rolfluc/ElectronicCribbage/readme.md

Repo Housing everything related to the electronic cribbage board project.
SW/ Contains everything for SW, including for test boards.
EE/ Contains all electrical aspects
HW/ Contains all HW related aspects
