rolfluc/ElectronicCribbage/EE/Main/MainBoard/MainBoard.step

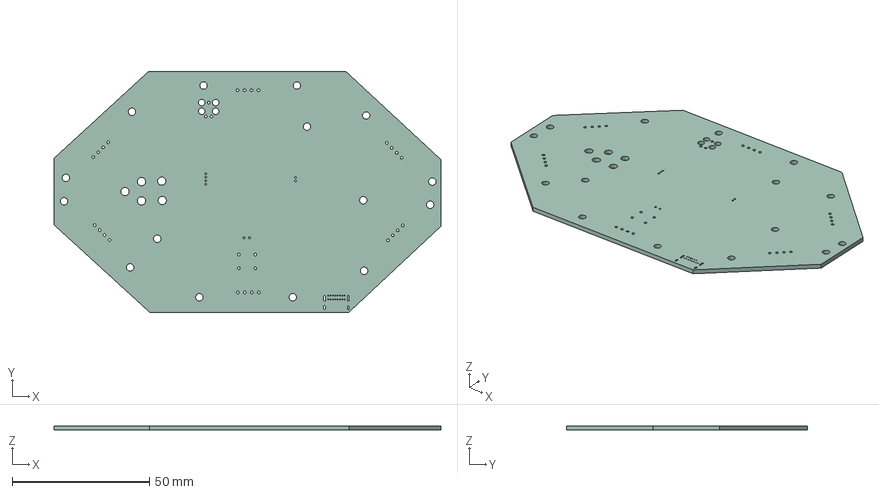
[picture p1: CAD file, 2025-07-29]
EE/Main/MainBoard/MainBoard.step
140.8 x 87.5 x 1.60 mm
