rolfluc/ElectronicCribbage/EE/Sensing/SensorBoard/SensorBoard.step

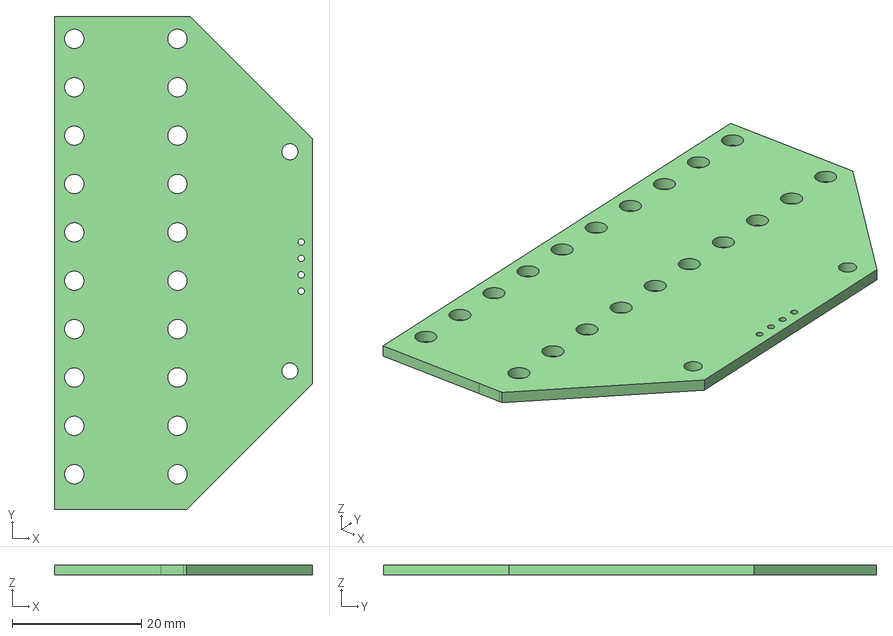
[picture p2: CAD file, 2024-10-20]
EE/Sensing/SensorBoard/SensorBoard.step
40.0 x 76.5 x 1.60 mm
