rolfluc/ElectronicCribbage/HW/CribbageCase.FCStd

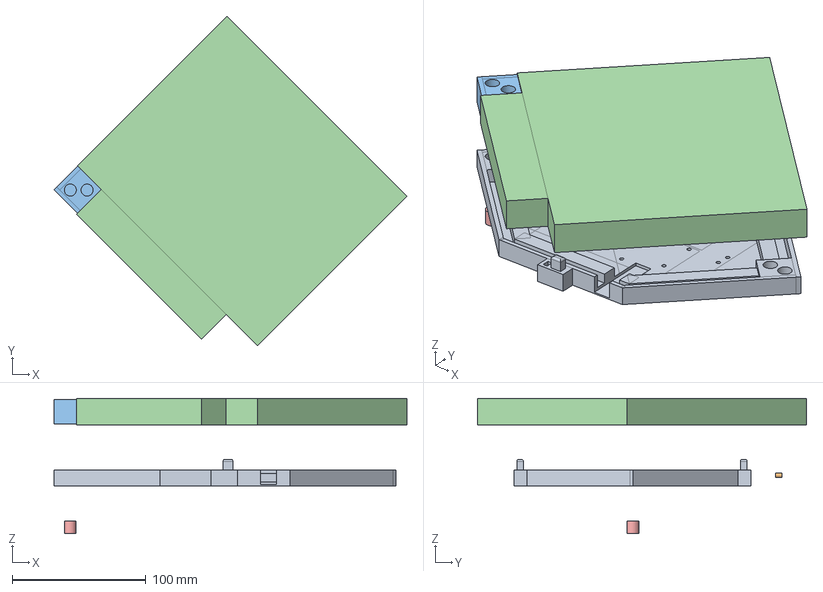
[picture p3: CAD file, 2025-08-26]
HW/CribbageCase.FCStd
263.7 x 246.1 x 101.0 mm
Magnet
