rolfluc/ElectronicCribbage/HW/CribbagePeg.FCStd

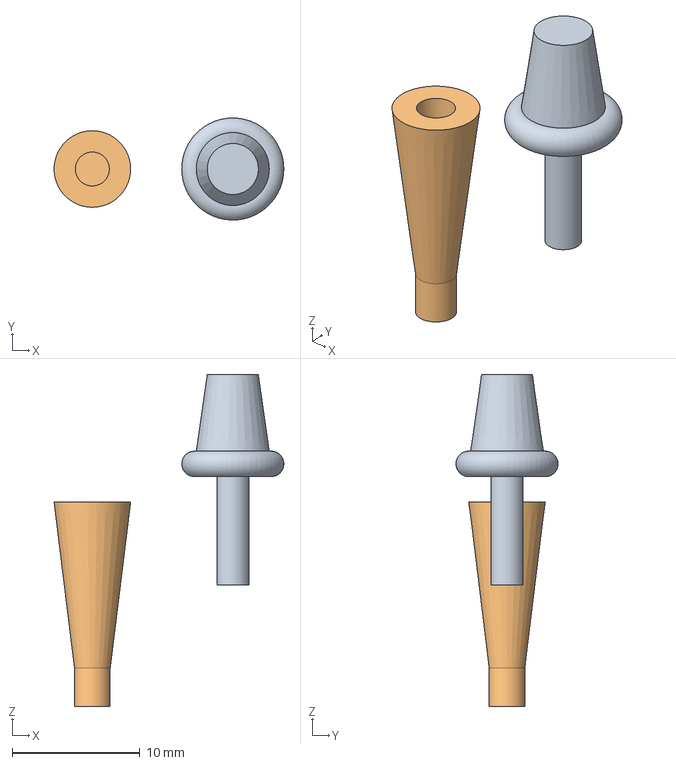
[picture p4: CAD file, 2025-08-24]
HW/CribbagePeg.FCStd
18.0 x 8.00 x 26.0 mm
