rolfluc/ElectronicCribbage/EE/Main/Power_DriveTest/PowerDriveTest/PowerDriveTest.kicad_pcb

## KiCad design EE/Main/Power_DriveTest/PowerDriveTest/PowerDriveTest.kicad_pcb (2025-08-29)

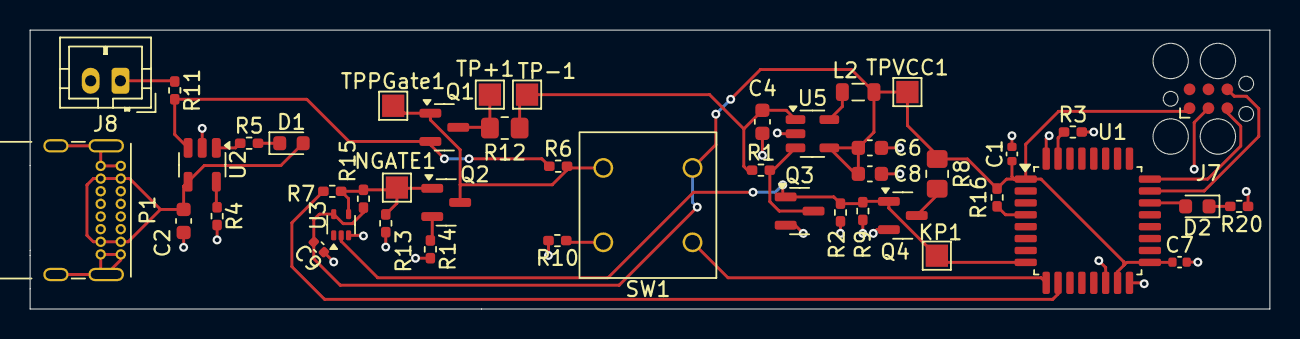
[picture p5: board PowerDriveTest.kicad_pcb from above]

Board: 2 copper layers, 83.3 x 18.8 mm, 45 parts (0 on the bottom side), 26 nets.

Parts:
C1, C7, C9: 0.1u; C_0402_1005Metric
C2, C4, C6, C8: 4.7u; C_0603_1608Metric
D1, D2: LED; LED_0603_1608Metric
J7: TAG_CONNECT; Tag-Connect_TC2030-IDC-FP_2x03_P1.27mm_Vertical
J8: Conn_01x02_Male; JST_PH_B2B-PH-K_1x02_P2.00mm_Vertical
KP1: TestPoint; TestPoint_Pad_1.5x1.5mm
L2: 4.7u; L_0805_2012Metric
NGATE1: TestPoint; TestPoint_Pad_1.5x1.5mm
P1: USB_C_Plug_USB2.0; USB_C_Receptacle_GCT_USB4085
Q1: Q_PMOS_GSD; SOT-23
Q2, Q3, Q4: Q_NMOS_GSD; SOT-23
R1, R2, R9, R13: 100k; R_0402_1005Metric_Pad0.72x0.64mm_HandSolder
R3, R4, R10, R14, R16: 10k; R_0402_1005Metric_Pad0.72x0.64mm_HandSolder
R5, R20: 4.7k; R_0402_1005Metric_Pad0.72x0.64mm_HandSolder
R6: 1M; R_0402_1005Metric_Pad0.72x0.64mm_HandSolder
R7, R11: 0; R_0402_1005Metric_Pad0.72x0.64mm_HandSolder
R8: 10; R_0805_2012Metric_Pad1.20x1.40mm_HandSolder
R12: 25m; R_0805_2012Metric_Pad1.20x1.40mm_HandSolder
R15: 10K; R_0402_1005Metric_Pad0.72x0.64mm_HandSolder
SW1: SW_DPST; 401-1133-ND
TP+1: TestPoint; TestPoint_Pad_1.5x1.5mm
TP-1: TestPoint; TestPoint_Pad_1.5x1.5mm
TPPGate1: TestPoint; TestPoint_Pad_1.5x1.5mm
TPVCC1: TestPoint; TestPoint_Pad_1.5x1.5mm
U1: STM32G431K6Tx; LQFP-32_7x7mm_P0.8mm
U2: MCP73832-2-OT; SOT-23-5
U3: 74LVC1GU04DRL; SOT-553
U5: LM3670MF-3.3; TSOT-23-5

Connections:
+3V3: C1.1, C6.1, C7.1, C8.1, C9.1, J7.1 (POWER_3V3), L2.2, R8.1, R15.1, R16.1, SW1.1, TPVCC1.1, U1.1 (VDD), U1.15 (VDDA), U1.17 (VDD), U3.5 (VCC), U5.4 (FB)
/BTN_SNS: SW1.2, U1.9 (PA4)
/EN: Q3.3 (D), R1.2, U5.3 (EN)
/HB: D2.2 (A), U1.22 (PA12)
/KillPower: KP1.1, Q3.1 (G), Q4.1 (G), R2.1, R9.1, U1.8 (PA3), U3.2
/N_GATE: R7.1, U1.10 (PA5)
/N_SOURCE: Q2.2 (S), R14.1
/P_DRAIN: Q1.3 (D), R12.2, TP+1.1
/SWDCLK: J7.5 (SWCLK), U1.24 (PA14)
/SWDIO: J7.6 (SWDIO), U1.23 (PA13)
/VBAT: Q1.2 (S), R6.1, R11.2, U2.3 (VBAT)
/VBAT_OUT: C4.1, R1.1, R12.1, TP-1.1, U5.1 (Vin)
GND: C1.2, C2.2, C4.2, C6.2, C7.2, C8.2, C9.2, J7.3 (GND), J8.2, P1.A1 (GND), P1.A12 (GND), P1.B1 (GND), P1.B12 (GND), P1.S1 (SHIELD), Q3.2 (S), Q4.2 (S), R2.2, R3.2, R4.2, R9.2, R10.2, R13.2, R14.2, R20.1, U1.14 (VSSA), U1.16 (VSS), U1.32 (VSS), U2.2 (VSS), U3.3 (GND), U5.2 (GND)
unnamed: D1.1 (K), R5.2
unnamed: D2.1 (K), R20.2
unnamed: J8.1, R11.1
unnamed: Q1.1 (G), Q2.3 (D), R6.2, SW1.3, TPPGate1.1
unnamed: NGATE1.1, Q2.1 (G), R7.2, R13.1, R15.2, U3.4
unnamed: Q4.3 (D), R8.2
unnamed: R10.1, SW1.4
unnamed: R3.1, U1.31 (PB8)
unnamed: R16.2, U1.4 (PG10)
unnamed: R4.1, U2.5 (PROG)
unnamed: R5.1, U2.1 (STAT)
unnamed: L2.1, U5.5 (SW)
VBUS: C2.1, D1.2 (A), P1.A4 (VBUS), P1.A9 (VBUS), P1.B4 (VBUS), P1.B9 (VBUS), U2.4 (VDD)
