rolfluc/ElectronicCribbage/EE/Sensing/SensorBoard/SensorBoard.kicad_pcb

## KiCad design EE/Sensing/SensorBoard/SensorBoard.kicad_pcb (2024-10-02)

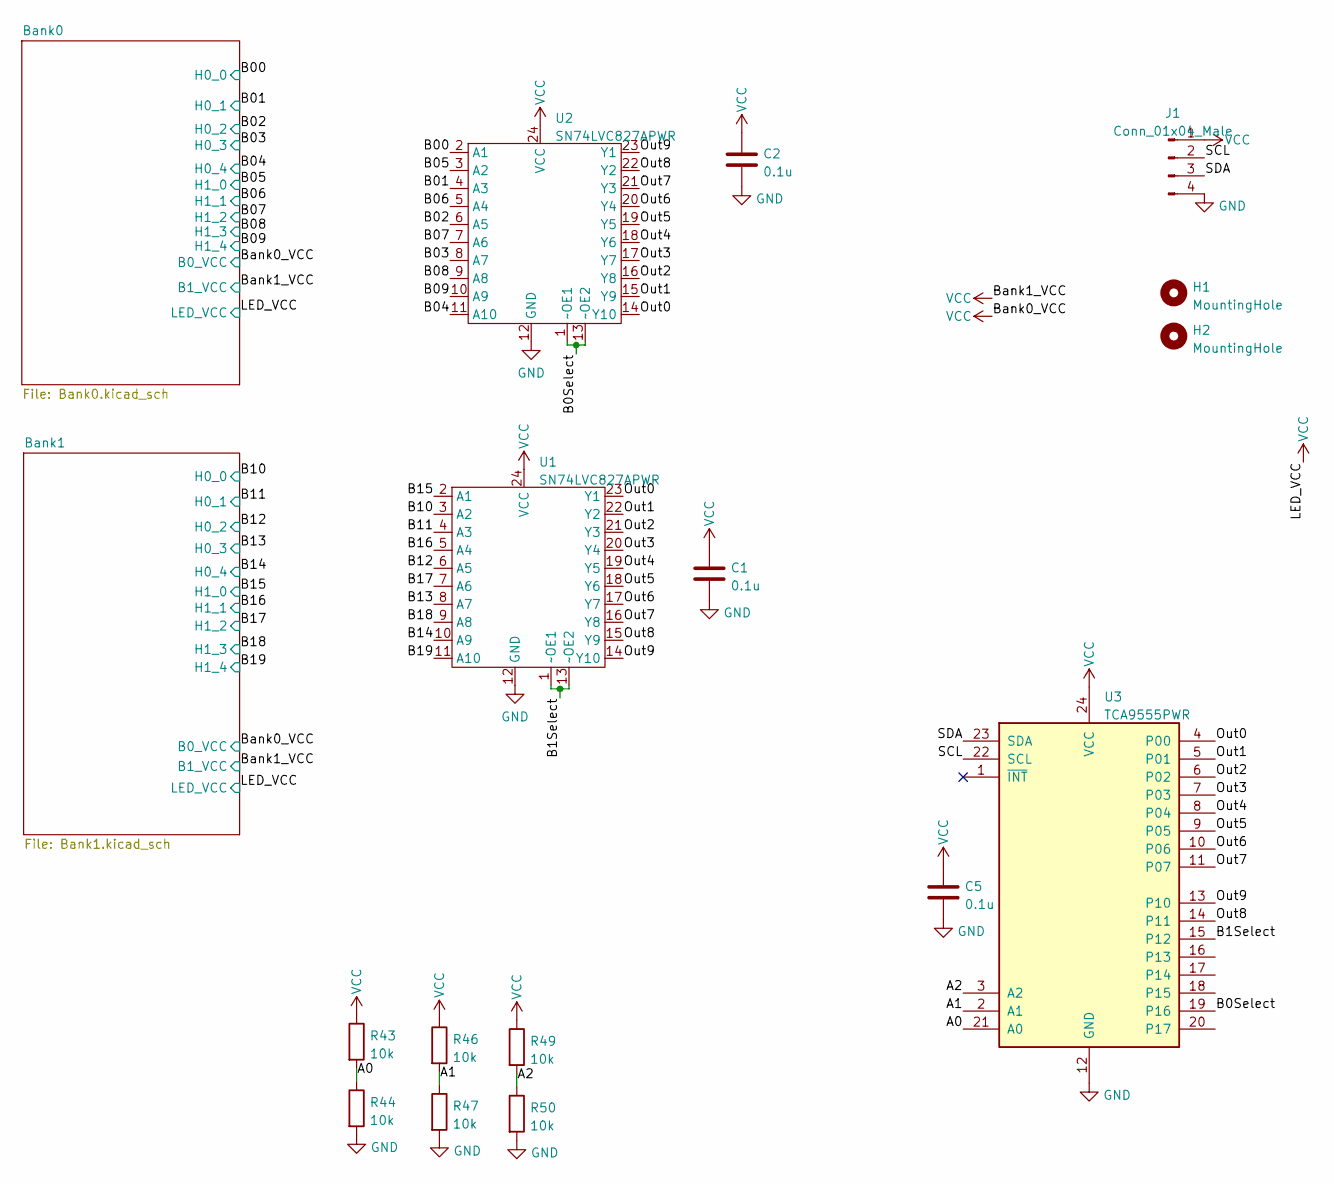
[picture p6: schematic SensorBoard.kicad_sch]

Parts:
C1, C2, C5: 0.1u; C_0402_1005Metric
H1, H2: MountingHole; MountingHole_2.5mm
J1: Conn_01x04_Male; PinSocket_1x04_P2.54mm_Vertical
R43, R44, R46, R47, R49, R50: 10k; R_0402_1005Metric
U1, U2: SN74LVC827APWR; TSSOP-24_4.4x7.8mm_P0.65mm
U3: TCA9555PWR; TSSOP-24_4.4x7.8mm_P0.65mm

Connections:
/A0: R43.2, R44.1, U3.21 (A0)
/A1: R46.2, R47.1, U3.2 (A1)
/A2: R49.2, R50.1, U3.3 (A2)
/B00: U2.2 (A1); also elsewhere on the board
/B0Select: U2.1 (~OE1), U2.13 (~OE2), U3.19 (P16)
/B01: U2.4 (A3); also elsewhere on the board
/B1Select: U1.1 (~OE1), U1.13 (~OE2), U3.15 (P12)
/B02: U2.6 (A5); also elsewhere on the board
/B03: U2.8 (A7); also elsewhere on the board
/B04: U2.11 (A10); also elsewhere on the board
/B05: U2.3 (A2); also elsewhere on the board
/B06: U2.5 (A4); also elsewhere on the board
/B07: U2.7 (A6); also elsewhere on the board
/B08: U2.9 (A8); also elsewhere on the board
/B09: U2.10 (A9); also elsewhere on the board
/B10: U1.3 (A2); also elsewhere on the board
/B11: U1.4 (A3); also elsewhere on the board
/B12: U1.6 (A5); also elsewhere on the board
/B13: U1.8 (A7); also elsewhere on the board
/B14: U1.10 (A9); also elsewhere on the board
/B15: U1.2 (A1); also elsewhere on the board
/B16: U1.5 (A4); also elsewhere on the board
/B17: U1.7 (A6); also elsewhere on the board
/B18: U1.9 (A8); also elsewhere on the board
/B19: U1.11 (A10); also elsewhere on the board
/Out0: U1.23 (Y1), U2.14 (Y10), U3.4 (P00)
/Out1: U1.22 (Y2), U2.15 (Y9), U3.5 (P01)
/Out2: U1.21 (Y3), U2.16 (Y8), U3.6 (P02)
/Out3: U1.20 (Y4), U2.17 (Y7), U3.7 (P03)
/Out4: U1.19 (Y5), U2.18 (Y6), U3.8 (P04)
/Out5: U1.18 (Y6), U2.19 (Y5), U3.9 (P05)
/Out6: U1.17 (Y7), U2.20 (Y4), U3.10 (P06)
/Out7: U1.16 (Y8), U2.21 (Y3), U3.11 (P07)
/Out8: U1.15 (Y9), U2.22 (Y2), U3.14 (P11)
/Out9: U1.14 (Y10), U2.23 (Y1), U3.13 (P10)
/SCL: J1.2, U3.22 (SCL)
/SDA: J1.3, U3.23 (SDA)
GND: C1.2, C2.2, C5.2, J1.4, R44.2, R47.2, R50.2, U1.12 (GND), U2.12 (GND), U3.12 (GND); also elsewhere on the board
VCC: C1.1, C2.1, C5.1, J1.1, R43.1, R46.1, R49.1, U1.24 (VCC), U2.24 (VCC), U3.24 (VCC); also elsewhere on the board

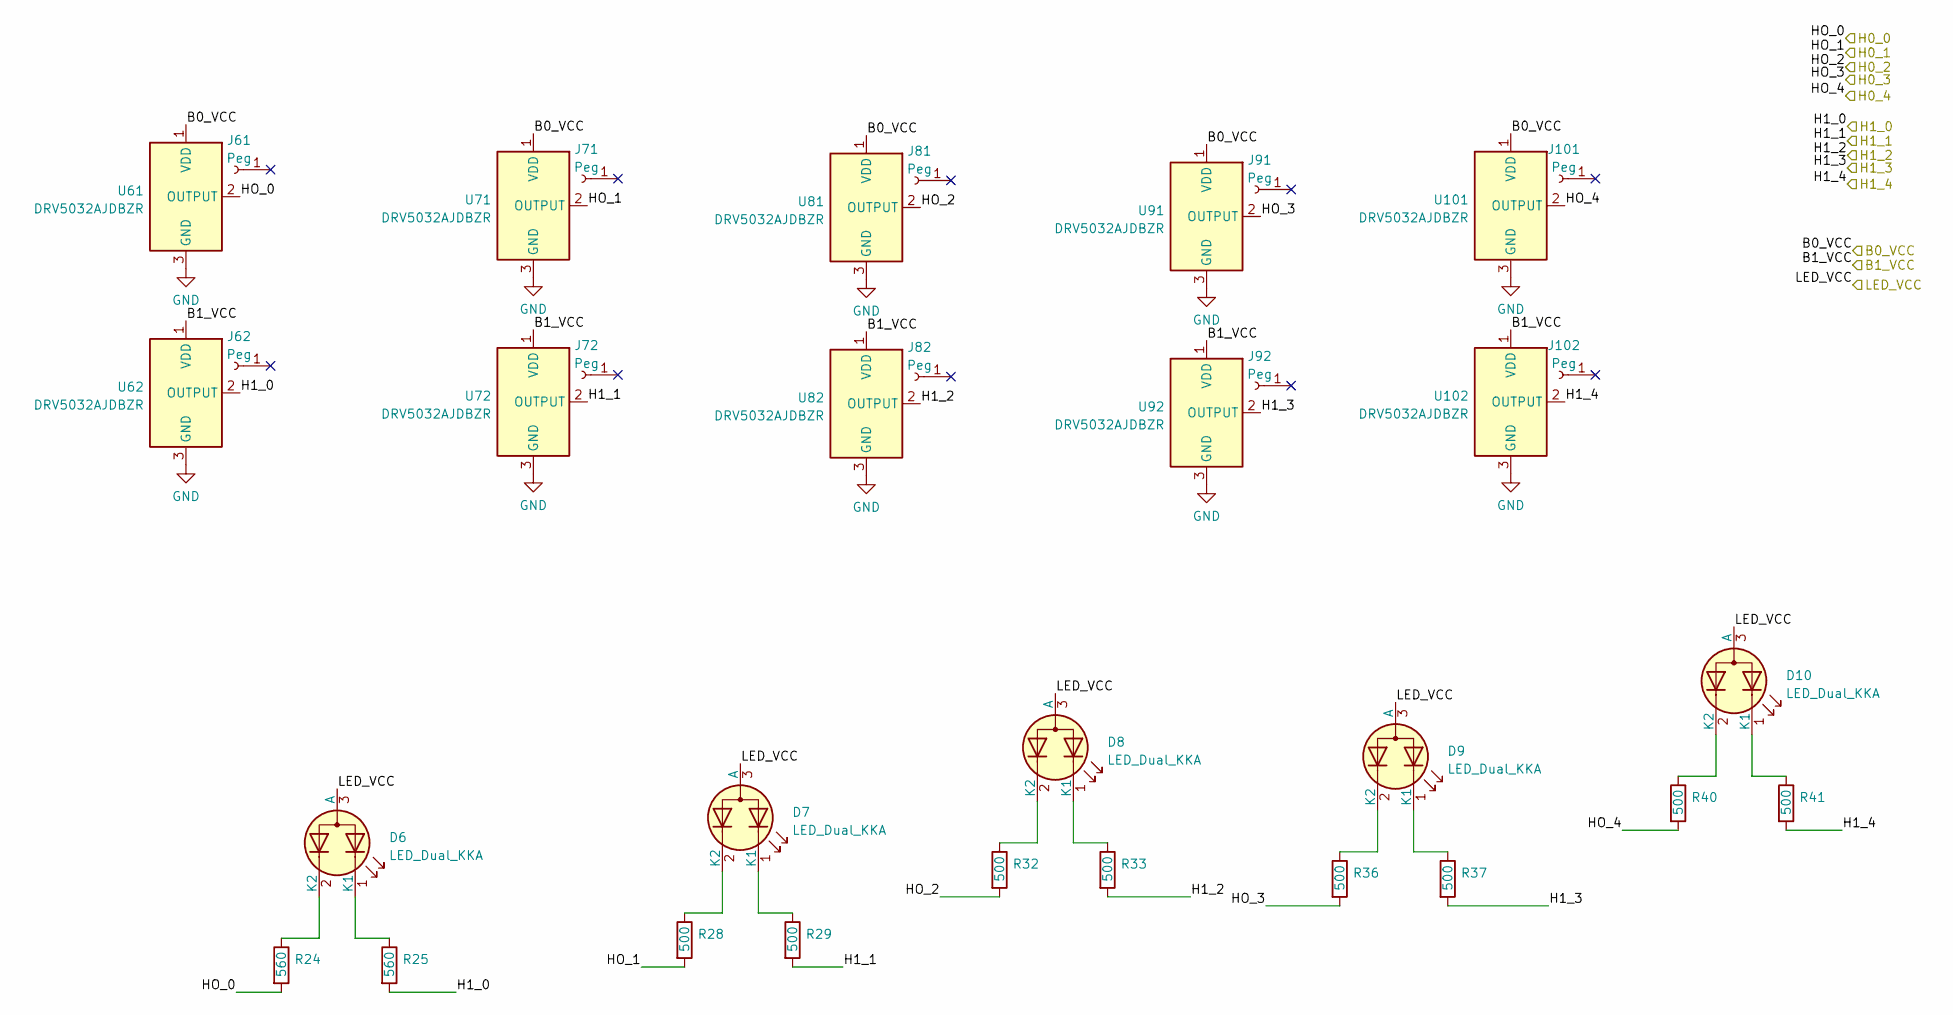
[picture p7: schematic Bank1.kicad_sch]

Parts:
D6, D7, D8, D9, D10: LED_Dual_KKA; SOT-23
J61, J62, J71, J72, J81, J82, J91, J92, J101, J102: Peg; TestPattern0
R24, R25: 560; R_0402_1005Metric_Pad0.72x0.64mm_HandSolder
R28, R29, R32, R33, R36, R37, R40, R41: 500; R_0402_1005Metric_Pad0.72x0.64mm_HandSolder
U61, U62, U71, U72, U81, U82, U91, U92, U101, U102: DRV5032AJDBZR; SOT-23

Connections:
/B10: R24.2, U61.2 (OUTPUT); also elsewhere on the board
/B11: R28.2, U71.2 (OUTPUT); also elsewhere on the board
/B12: R32.2, U81.2 (OUTPUT); also elsewhere on the board
/B13: R36.2, U91.2 (OUTPUT); also elsewhere on the board
/B14: R40.2, U101.2 (OUTPUT); also elsewhere on the board
/B15: R25.2, U62.2 (OUTPUT); also elsewhere on the board
/B16: R29.2, U72.2 (OUTPUT); also elsewhere on the board
/B17: R33.2, U82.2 (OUTPUT); also elsewhere on the board
/B18: R37.2, U92.2 (OUTPUT); also elsewhere on the board
/B19: R41.2, U102.2 (OUTPUT); also elsewhere on the board
GND: U61.3 (GND), U62.3 (GND), U71.3 (GND), U72.3 (GND), U81.3 (GND), U82.3 (GND), U91.3 (GND), U92.3 (GND), U101.3 (GND), U102.3 (GND); also elsewhere on the board
unnamed: D6.1 (K1), R25.1
unnamed: D6.2 (K2), R24.1
unnamed: D7.1 (K1), R29.1
unnamed: D7.2 (K2), R28.1
unnamed: D8.1 (K1), R33.1
unnamed: D8.2 (K2), R32.1
unnamed: D9.1 (K1), R37.1
unnamed: D9.2 (K2), R36.1
unnamed: D10.1 (K1), R41.1
unnamed: D10.2 (K2), R40.1
VCC: D6.3 (A), D7.3 (A), D8.3 (A), D9.3 (A), D10.3 (A), U61.1 (VDD), U62.1 (VDD), U71.1 (VDD), U72.1 (VDD), U81.1 (VDD), U82.1 (VDD), U91.1 (VDD), U92.1 (VDD), U101.1 (VDD), U102.1 (VDD); also elsewhere on the board

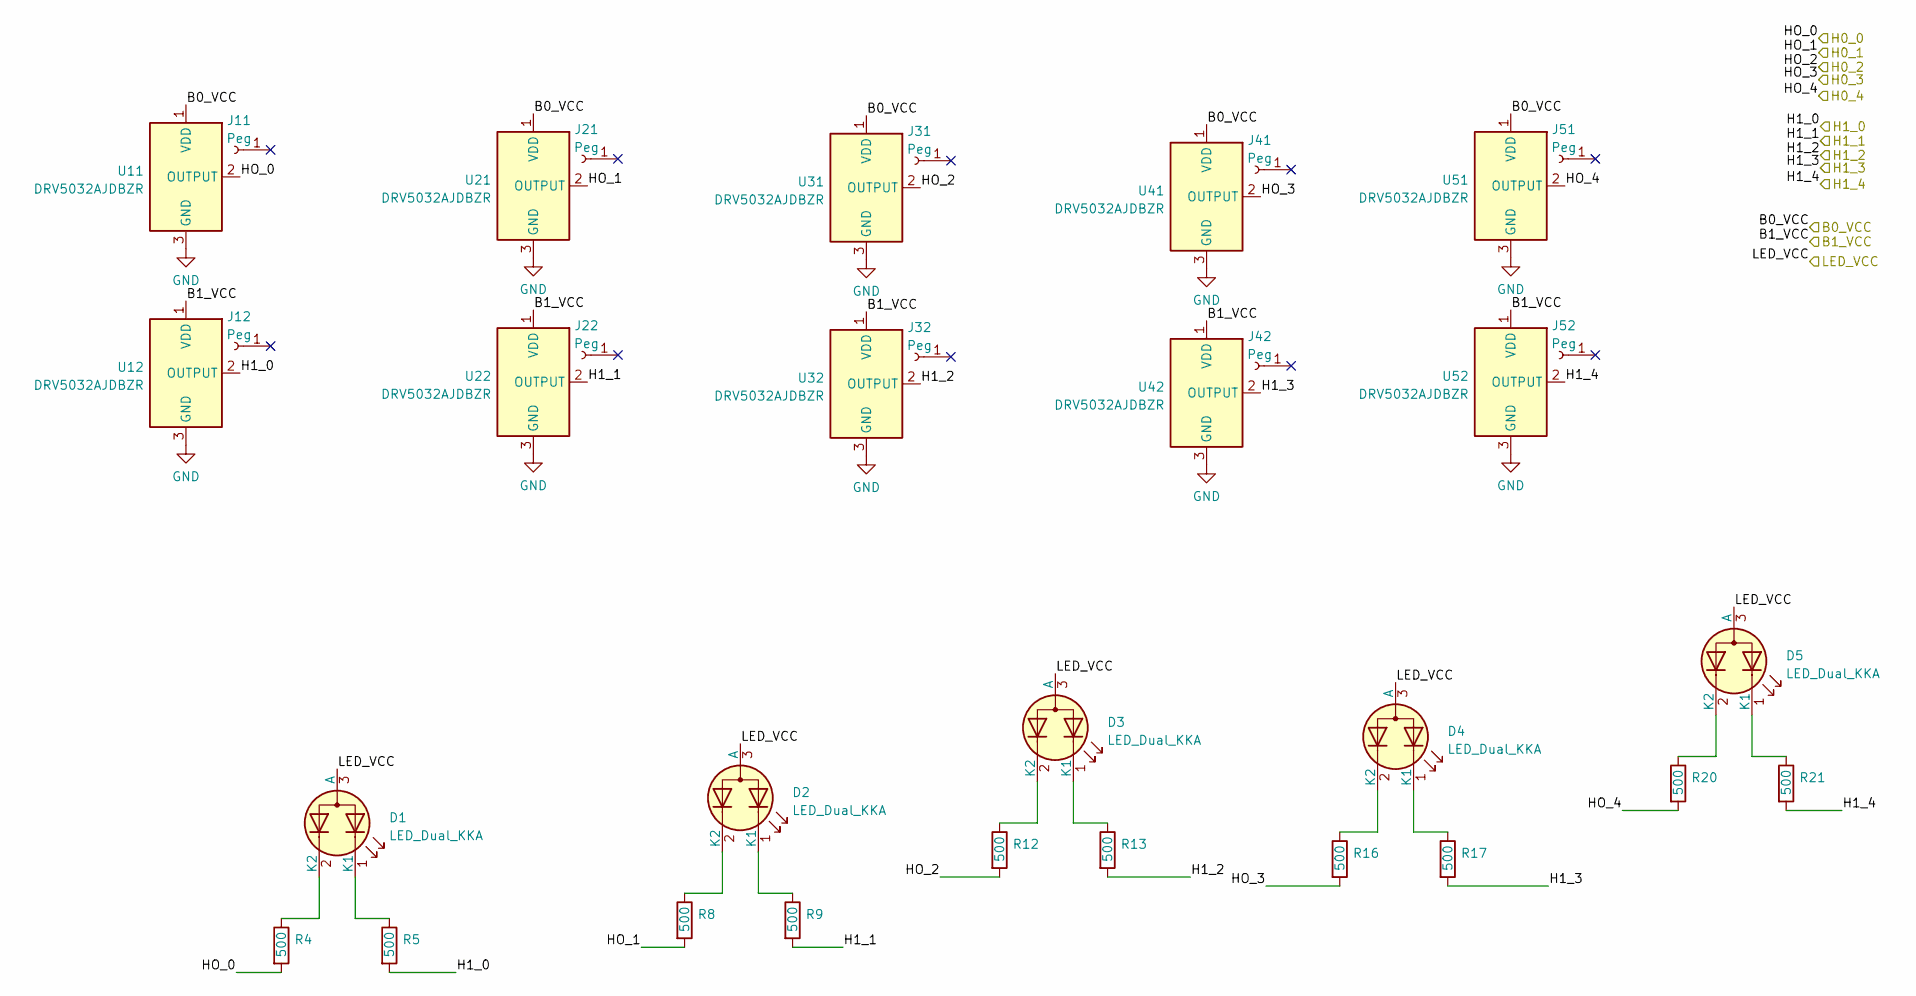
[picture p8: schematic Bank0.kicad_sch]

Parts:
D1, D2, D3, D4, D5: LED_Dual_KKA; SOT-23
J11, J12, J21, J22, J31, J32, J41, J42, J51, J52: Peg; TestPattern0
R4, R5, R8, R9, R12, R13, R16, R17, R20, R21: 500; R_0402_1005Metric_Pad0.72x0.64mm_HandSolder
U11, U12, U21, U22, U31, U32, U41, U42, U51, U52: DRV5032AJDBZR; SOT-23

Connections:
/B00: R4.2, U11.2 (OUTPUT); also elsewhere on the board
/B01: R8.2, U21.2 (OUTPUT); also elsewhere on the board
/B02: R12.2, U31.2 (OUTPUT); also elsewhere on the board
/B03: R16.2, U41.2 (OUTPUT); also elsewhere on the board
/B04: R20.2, U51.2 (OUTPUT); also elsewhere on the board
/B05: R5.2, U12.2 (OUTPUT); also elsewhere on the board
/B06: R9.2, U22.2 (OUTPUT); also elsewhere on the board
/B07: R13.2, U32.2 (OUTPUT); also elsewhere on the board
/B08: R17.2, U42.2 (OUTPUT); also elsewhere on the board
/B09: R21.2, U52.2 (OUTPUT); also elsewhere on the board
GND: U11.3 (GND), U12.3 (GND), U21.3 (GND), U22.3 (GND), U31.3 (GND), U32.3 (GND), U41.3 (GND), U42.3 (GND), U51.3 (GND), U52.3 (GND); also elsewhere on the board
unnamed: D1.1 (K1), R5.1
unnamed: D1.2 (K2), R4.1
unnamed: D2.1 (K1), R9.1
unnamed: D2.2 (K2), R8.1
unnamed: D3.1 (K1), R13.1
unnamed: D3.2 (K2), R12.1
unnamed: D4.1 (K1), R17.1
unnamed: D4.2 (K2), R16.1
unnamed: D5.1 (K1), R21.1
unnamed: D5.2 (K2), R20.1
VCC: D1.3 (A), D2.3 (A), D3.3 (A), D4.3 (A), D5.3 (A), U11.1 (VDD), U12.1 (VDD), U21.1 (VDD), U22.1 (VDD), U31.1 (VDD), U32.1 (VDD), U41.1 (VDD), U42.1 (VDD), U51.1 (VDD), U52.1 (VDD); also elsewhere on the board

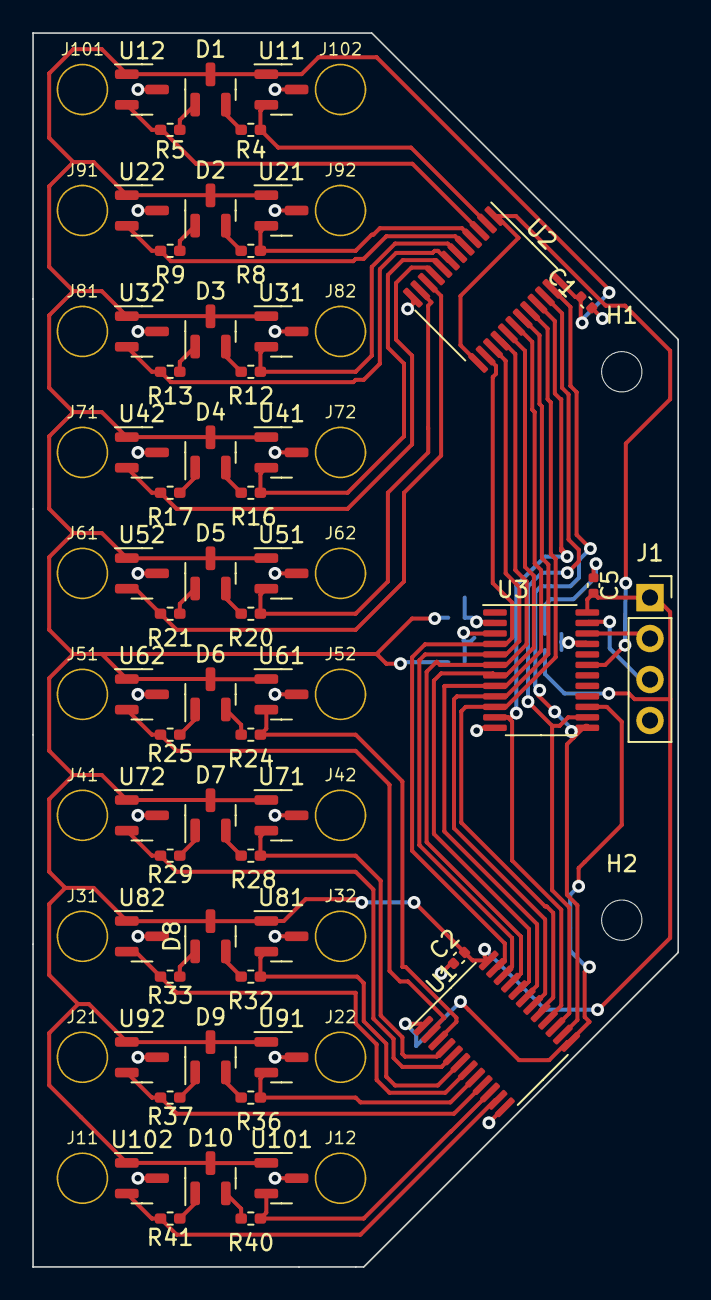
[picture p9: board SensorBoard.kicad_pcb from above]

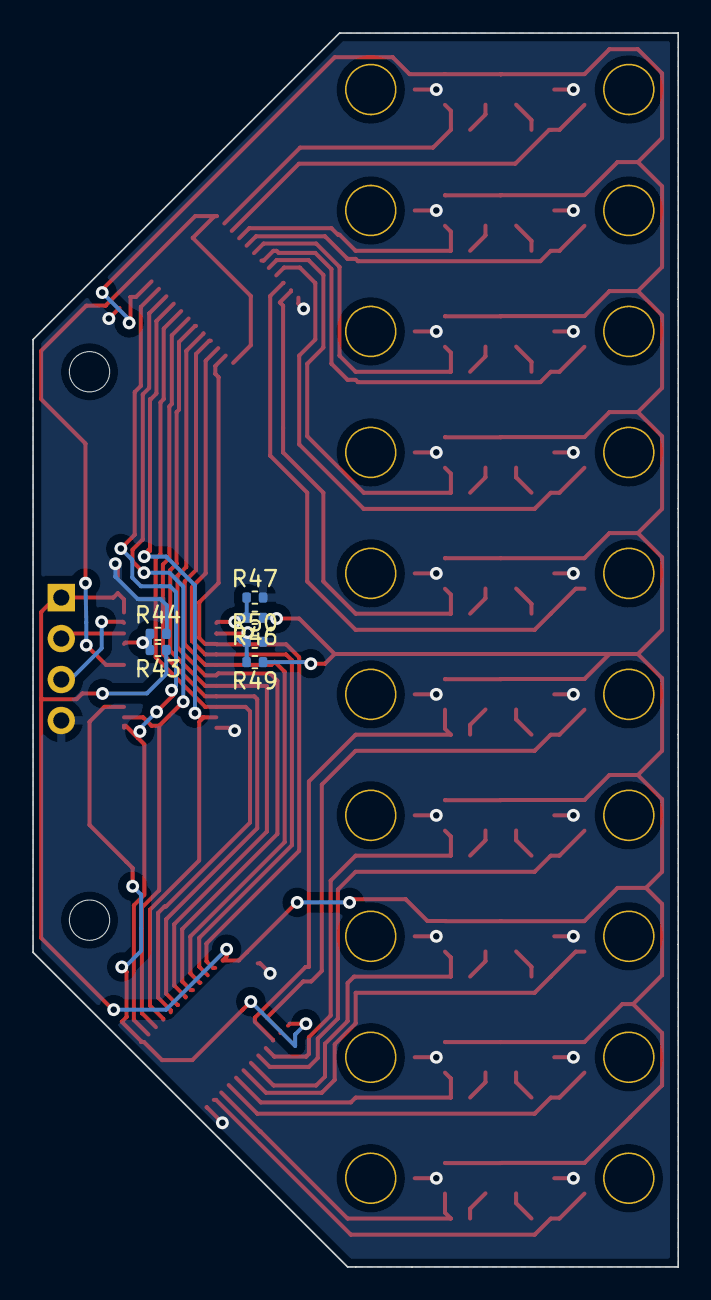
[picture p10: board SensorBoard.kicad_pcb from below]

Board: 2 copper layers, 40.0 x 76.5 mm, 85 parts (6 on the bottom side), 59 nets.
