rolfluc/ElectronicCribbage/EE/TestBoard1/TB1/TB1.kicad_pcb

## KiCad design EE/TestBoard1/TB1/TB1.kicad_pcb (2024-02-06)

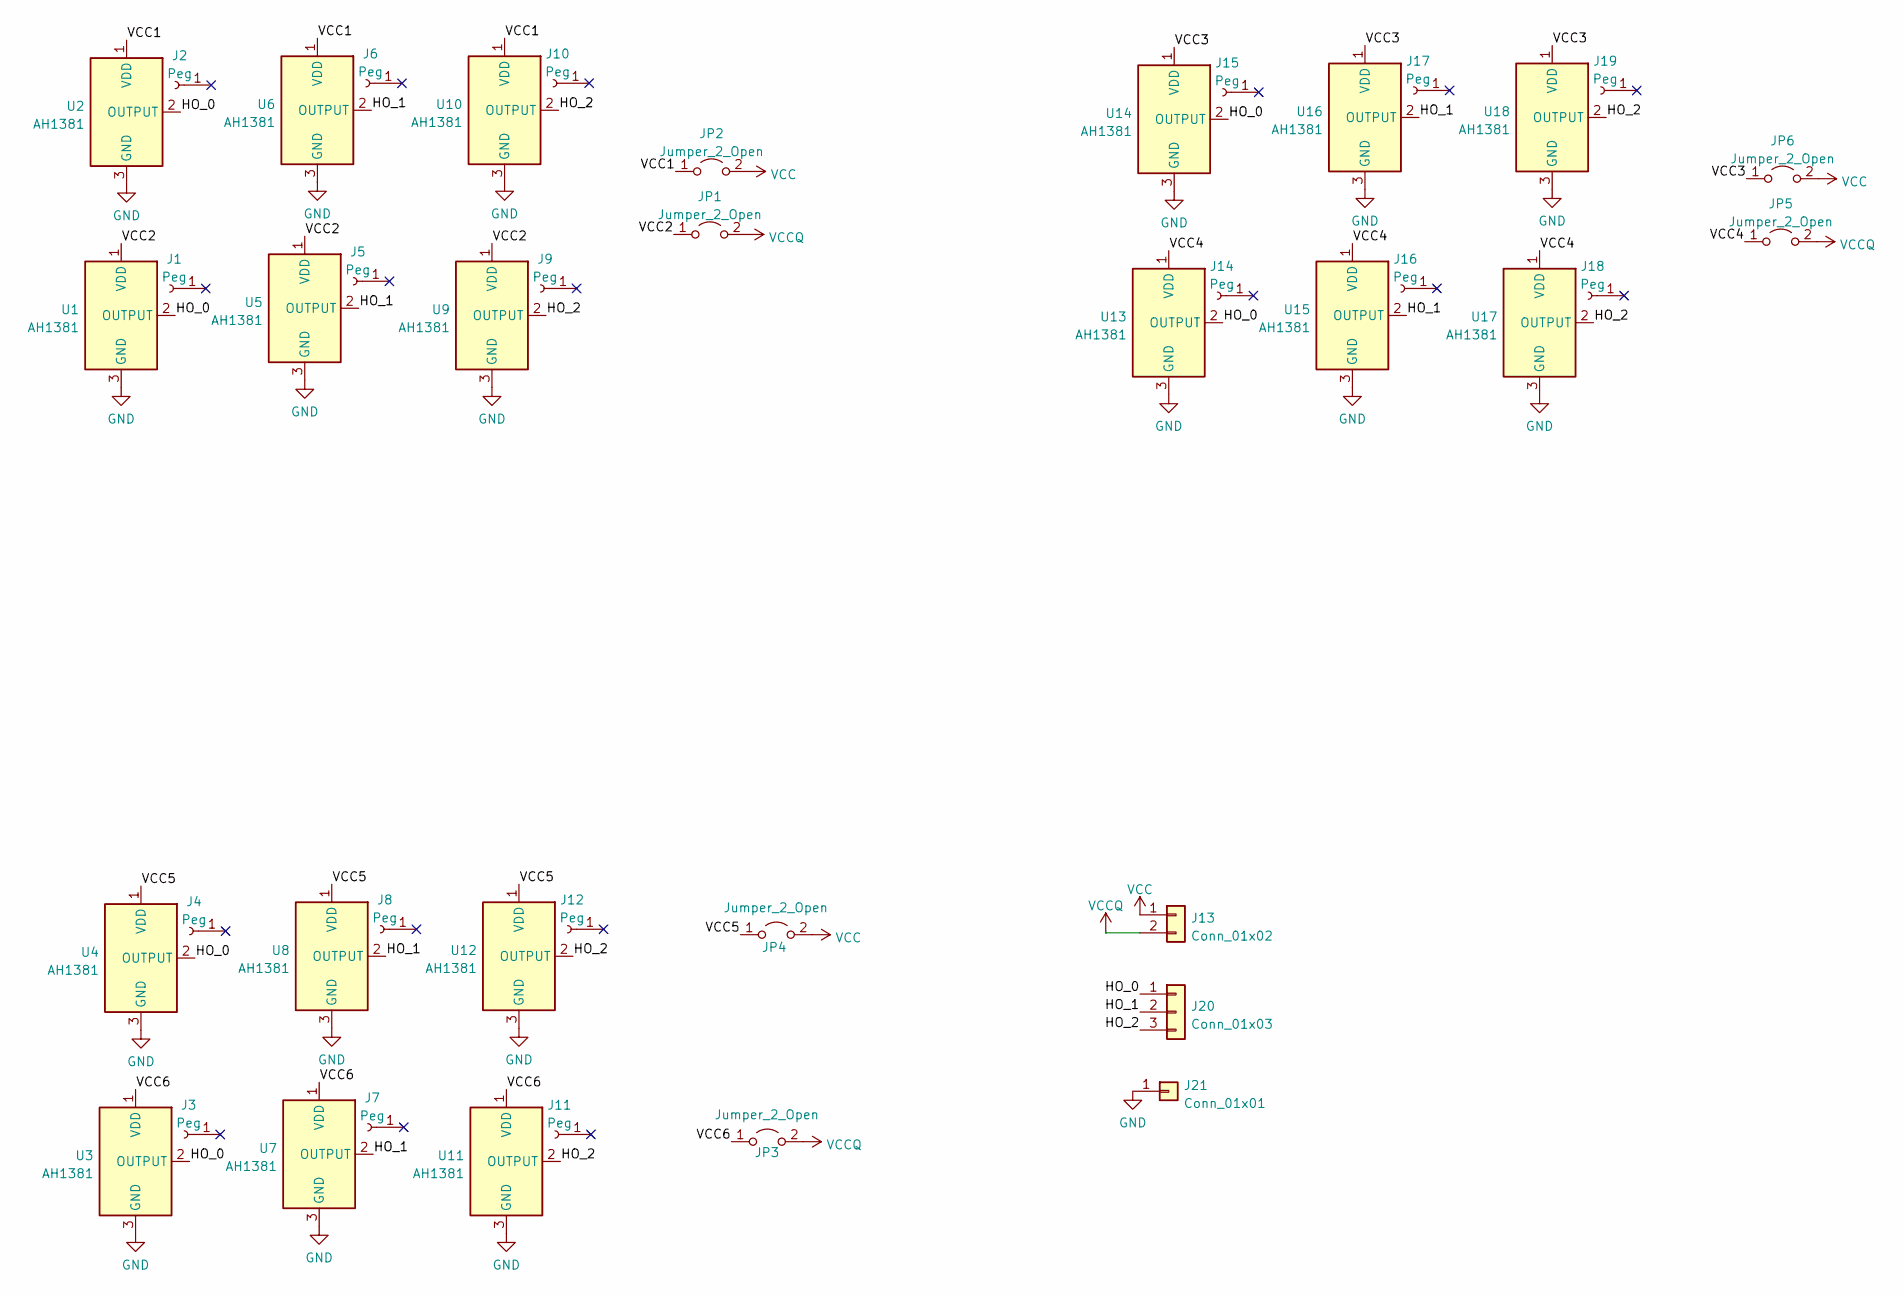
[picture p11: schematic TB1.kicad_sch]

Parts:
J1, J2, J5, J6, J9, J10: Peg; TestPattern0
J3, J4, J7, J8, J11, J12: Peg; TestPattern1
J13: Conn_01x02; PinHeader_1x02_P2.54mm_Vertical
J14, J15, J16, J17, J18, J19: Peg; TestPattern2
J20: Conn_01x03; PinHeader_1x03_P2.54mm_Vertical
J21: Conn_01x01; PinHeader_1x01_P2.54mm_Vertical
JP1, JP2, JP3, JP4, JP5, JP6: Jumper_2_Open; SolderJumper-2_P1.3mm_Open_Pad1.0x1.5mm
U1, U2, U3, U4, U5, U6, U7, U8, U9, U10, U11, U12, U13, U14, U15, U16, U17, U18: AH1381; SOT-23

Connections:
/HO_0: J20.1, U1.2 (OUTPUT), U2.2 (OUTPUT), U3.2 (OUTPUT), U4.2 (OUTPUT), U13.2 (OUTPUT), U14.2 (OUTPUT)
/HO_1: J20.2, U5.2 (OUTPUT), U6.2 (OUTPUT), U7.2 (OUTPUT), U8.2 (OUTPUT), U15.2 (OUTPUT), U16.2 (OUTPUT)
/HO_2: J20.3, U9.2 (OUTPUT), U10.2 (OUTPUT), U11.2 (OUTPUT), U12.2 (OUTPUT), U17.2 (OUTPUT), U18.2 (OUTPUT)
/VCC1: JP2.1 (A), U2.1 (VDD), U6.1 (VDD), U10.1 (VDD)
/VCC2: JP1.1 (A), U1.1 (VDD), U5.1 (VDD), U9.1 (VDD)
/VCC3: JP6.1 (A), U14.1 (VDD), U16.1 (VDD), U18.1 (VDD)
/VCC4: JP5.1 (A), U13.1 (VDD), U15.1 (VDD), U17.1 (VDD)
/VCC5: JP4.1 (A), U4.1 (VDD), U8.1 (VDD), U12.1 (VDD)
/VCC6: JP3.1 (A), U3.1 (VDD), U7.1 (VDD), U11.1 (VDD)
GND: J21.1, U1.3 (GND), U2.3 (GND), U3.3 (GND), U4.3 (GND), U5.3 (GND), U6.3 (GND), U7.3 (GND), U8.3 (GND), U9.3 (GND), U10.3 (GND), U11.3 (GND), U12.3 (GND), U13.3 (GND), U14.3 (GND), U15.3 (GND), U16.3 (GND), U17.3 (GND), U18.3 (GND)
VCC: J13.1, JP2.2 (B), JP4.2 (B), JP6.2 (B)
VCCQ: J13.2, JP1.2 (B), JP3.2 (B), JP5.2 (B)

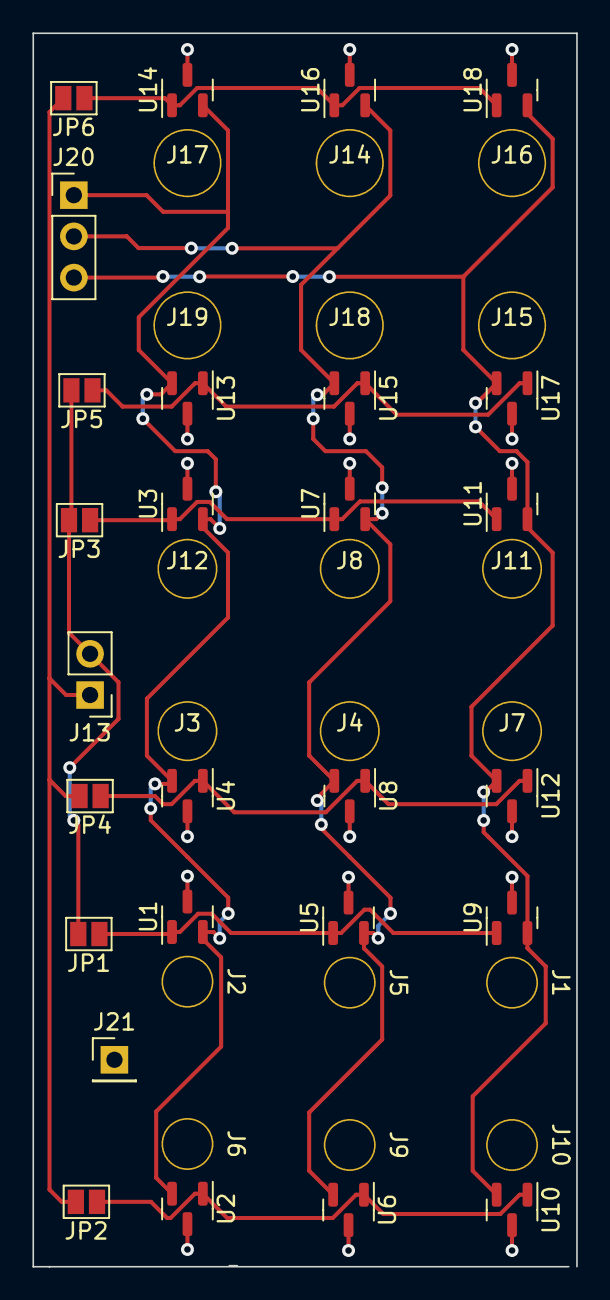
[picture p12: board TB1.kicad_pcb from above]

Board: 2 copper layers, 33.5 x 76.0 mm, 45 parts (0 on the bottom side), 12 nets.
