rolfluc/ElectronicCribbage/EE/TestBoard1/TB2_Sensor_Lightboard/TB2/TB2.kicad_pcb

## KiCad design EE/TestBoard1/TB2_Sensor_Lightboard/TB2/TB2.kicad_pcb (2024-02-19)

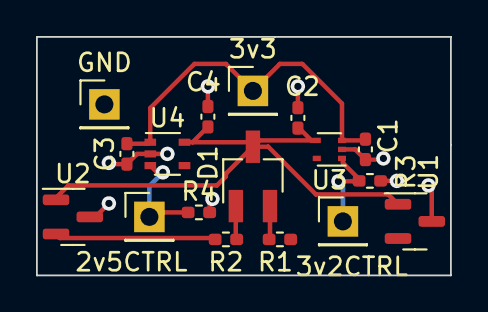
[picture p13: board TB2.kicad_pcb from above]

Board: 2 copper layers, 23.0 x 13.2 mm, 17 parts (0 on the bottom side), 9 nets.

Parts:
2v5CTRL, 3v2CTRL, 3v3: Conn_01x01_Female; PinHeader_1x01_P2.54mm_Vertical
C1, C2, C3, C4: 0.1u; C_0402_1005Metric_Pad0.74x0.62mm_HandSolder
D1: LED_Dual_KKA; SC-59_Handsoldering
GND: Conn_01x01_Female; PinHeader_1x01_P2.54mm_Vertical
R1, R2: 1k; R_0402_1005Metric_Pad0.72x0.64mm_HandSolder
R3, R4: 100k; R_0402_1005Metric_Pad0.72x0.64mm_HandSolder
U1, U2: AH1381; SOT-23
U3: TCR2EE32; SOT-553
U4: MIC5365-2.5YC5; SOT-353_SC-70-5

Connections:
+3V3: 3v3.1, C1.1, C3.1, U3.3 (VIN), U4.1 (VIN)
/2v5_CTRL: 2v5CTRL.1, R4.1, U4.3 (EN)
/3v2_CTRL: 3v2CTRL.1, R3.1, U3.1 (CTRL)
/HO_0: R1.2, U1.2 (OUTPUT)
/HO_1: R2.2, U2.2 (OUTPUT)
GND: C1.2, C2.2, C3.2, C4.2, GND.1, R3.2, R4.2, U1.3 (GND), U2.3 (GND), U3.2 (GND), U4.2 (GND)
unnamed: D1.1 (K1), R2.1
unnamed: D1.2 (K2), R1.1
VCC: C2.1, C4.1, D1.3 (A), U1.1 (VDD), U2.1 (VDD), U3.4 (VOUT), U4.5 (VOUT)
