rolfluc/ElectronicCribbage/SW/Cribbage/Cribbage/main.c

#include <stm32g4xx_hal.h>
#include <stm32_hal_legacy.h>
#include "I2C.h"
#include "ExpanderController.h"
#include "PegHandler.h"
#include "PowerHandler.h"
#include "HB.h"
#include "ADC.h"
#include "SPI.h"

void Error_Handler()
{
	__ASM("BKPT 255");
}

void SysTick_Handler(void)
{
	HAL_IncTick();
	HAL_SYSTICK_IRQHandler();
}

void HAL_Delay(uint32_t Delay)
{
	uint32_t tickstart = HAL_GetTick();
	uint32_t wait = Delay;

	/* Add a freq to guarantee minimum wait */
	if (wait < HAL_MAX_DELAY)
	{
		wait += (uint32_t)(uwTickFreq);
	}

	while ((HAL_GetTick() - tickstart) < wait)
	{
		__WFI();
	}
}

void SystemClock_Config(void)
{
	RCC_OscInitTypeDef RCC_OscInitStruct = { 0 };
	RCC_ClkInitTypeDef RCC_ClkInitStruct = { 0 };

	/** Configure the main internal regulator output voltage
	*/
	HAL_PWREx_ControlVoltageScaling(PWR_REGULATOR_VOLTAGE_SCALE1);

	/** Initializes the RCC Oscillators according to the specified parameters
	* in the RCC_OscInitTypeDef structure.
	*/
	RCC_OscInitStruct.OscillatorType = RCC_OSCILLATORTYPE_HSI;
	RCC_OscInitStruct.HSIState = RCC_HSI_ON;
	RCC_OscInitStruct.HSICalibrationValue = RCC_HSICALIBRATION_DEFAULT;
	RCC_OscInitStruct.PLL.PLLState = RCC_PLL_NONE;
	if (HAL_RCC_OscConfig(&RCC_OscInitStruct) != HAL_OK)
	{
		Error_Handler();
	}

	/** Initializes the CPU, AHB and APB buses clocks
	*/
	RCC_ClkInitStruct.ClockType = RCC_CLOCKTYPE_HCLK | RCC_CLOCKTYPE_SYSCLK
	                            | RCC_CLOCKTYPE_PCLK1 | RCC_CLOCKTYPE_PCLK2;
	RCC_ClkInitStruct.SYSCLKSource = RCC_SYSCLKSOURCE_HSI;
	RCC_ClkInitStruct.AHBCLKDivider = RCC_SYSCLK_DIV1;
	RCC_ClkInitStruct.APB1CLKDivider = RCC_HCLK_DIV1;
	RCC_ClkInitStruct.APB2CLKDivider = RCC_HCLK_DIV1;

	if (HAL_RCC_ClockConfig(&RCC_ClkInitStruct, FLASH_LATENCY_0) != HAL_OK)
	{
		Error_Handler();
	}
}


int main(void)
{
	uint16_t adcVal = 0;
	HAL_Init();
	SystemClock_Config();
	__HAL_RCC_GPIOA_CLK_ENABLE();
	__HAL_RCC_GPIOB_CLK_ENABLE();
	InitHB();
	InitPowerSense();
	InitSPI();
	InitPegs();
	InitExpanders();
	
	InitADC();
	
	for (;;)
	{
		ToggleHB();
		
		HAL_Delay(100);
		adcVal = GetADCCount();
		// Start reading the banks.
		StartBankReadings();
		// Interpret the tca banks, and copy the results into the respective local buffers.
		UpdateBankInfo();
		// Now, run the state machine 
		HandlePegStateMachine(adcVal);
	}
}
