rolfluc/ElectronicCribbage/SW/Cribbage/Cribbage/SPI.c

#include  "SPI.h"
#include <stm32g4xx.h>
#include "PinDefs.h"

SPI_HandleTypeDef hspi1;
DMA_HandleTypeDef hdma_spi1_tx;

void DMA1_Channel1_IRQHandler(void)
{
	HAL_DMA_IRQHandler(&hdma_spi1_tx);
}

void InitSPI()
{
	__HAL_RCC_SPI1_CLK_ENABLE();
	__HAL_RCC_DMAMUX1_CLK_ENABLE();
	__HAL_RCC_DMA1_CLK_ENABLE();
	
	GPIO_InitTypeDef GPIO_InitStruct = { 0 };
	GPIO_InitStruct.Pin = Display_COUT.pinNumber;
	GPIO_InitStruct.Pull = GPIO_NOPULL;
	GPIO_InitStruct.Speed = GPIO_SPEED_FREQ_LOW;
	GPIO_InitStruct.Mode = GPIO_MODE_AF_PP;
	GPIO_InitStruct.Alternate = GPIO_AF5_SPI1;
	HAL_GPIO_Init(Display_COUT.pinPort, &GPIO_InitStruct);
	GPIO_InitStruct.Pin = Display_DOUT.pinNumber;
	HAL_GPIO_Init(Display_DOUT.pinPort, &GPIO_InitStruct);

	hdma_spi1_tx.Instance = DMA1_Channel1;
	hdma_spi1_tx.Init.Request = DMA_REQUEST_SPI1_TX;
	hdma_spi1_tx.Init.Direction = DMA_MEMORY_TO_PERIPH;
	hdma_spi1_tx.Init.PeriphInc = DMA_PINC_DISABLE;
	hdma_spi1_tx.Init.MemInc = DMA_MINC_ENABLE;
	hdma_spi1_tx.Init.PeriphDataAlignment = DMA_PDATAALIGN_BYTE;
	hdma_spi1_tx.Init.MemDataAlignment = DMA_MDATAALIGN_BYTE;
	hdma_spi1_tx.Init.Mode = DMA_NORMAL;
	hdma_spi1_tx.Init.Priority = DMA_PRIORITY_LOW;
	if (HAL_DMA_Init(&hdma_spi1_tx) != HAL_OK)
	{
		__ASM("BKPT 255");
	}

	__HAL_LINKDMA(&hspi1, hdmatx, hdma_spi1_tx);
	
	hspi1.Instance = SPI1;
	hspi1.Init.Mode = SPI_MODE_MASTER;
	hspi1.Init.Direction = SPI_DIRECTION_1LINE;
	hspi1.Init.DataSize = SPI_DATASIZE_8BIT;
	hspi1.Init.CLKPolarity = SPI_POLARITY_HIGH;
	hspi1.Init.CLKPhase = SPI_PHASE_2EDGE;
	hspi1.Init.NSS = SPI_NSS_SOFT;
	hspi1.Init.BaudRatePrescaler = SPI_BAUDRATEPRESCALER_4;
	hspi1.Init.FirstBit = SPI_FIRSTBIT_MSB;
	hspi1.Init.TIMode = SPI_TIMODE_DISABLE;
	hspi1.Init.CRCCalculation = SPI_CRCCALCULATION_DISABLE;
	hspi1.Init.CRCPolynomial = 7;
	hspi1.Init.CRCLength = SPI_CRC_LENGTH_DATASIZE;
	hspi1.Init.NSSPMode = SPI_NSS_PULSE_ENABLE; 
	if (HAL_SPI_Init(&hspi1) != HAL_OK)
	{
		__ASM("BKPT 255");
	}
	HAL_NVIC_SetPriority(DMA1_Channel1_IRQn, 0, 0);
	HAL_NVIC_EnableIRQ(DMA1_Channel1_IRQn);
}

void SendDisplay(uint8_t* buffer, uint32_t cnt)
{
	HAL_SPI_Transmit_DMA(&hspi1, buffer, cnt);
}
