rolfluc/ElectronicCribbage/SW/Cribbage/Cribbage/I2C.c

#include "I2C.h"
#include <PinDefs.h>

static const uint32_t i2cPinMode = GPIO_MODE_AF_OD;
static const uint32_t i2cPinPull = GPIO_NOPULL;
static const uint32_t i2cPinSpeed = GPIO_SPEED_FREQ_LOW;
static const uint32_t I2CTimeout_ms = 50;


I2C_HandleTypeDef hi2c;

static void InitializeI2CPins()
{
	GPIO_InitTypeDef init;
	init.Speed = i2cPinSpeed;
	init.Mode = i2cPinMode;
	init.Pull = i2cPinPull;
	init.Alternate = GPIO_AF4_I2C1;
	init.Pin = I2C_SDA.pinNumber;
	HAL_GPIO_Init(I2C_SDA.pinPort, &init);
	init.Pin = I2C_SCL.pinNumber;
	HAL_GPIO_Init(I2C_SCL.pinPort, &init);
}

void InitializeI2C()
{
	GPIO_InitTypeDef GPIO_InitStruct = { 0 };
	RCC_PeriphCLKInitTypeDef PeriphClkInit = { 0 };
	PeriphClkInit.PeriphClockSelection = RCC_PERIPHCLK_I2C1;
	PeriphClkInit.I2c1ClockSelection = RCC_I2C1CLKSOURCE_PCLK1;
	HAL_RCCEx_PeriphCLKConfig(&PeriphClkInit);
	__HAL_RCC_I2C1_CLK_ENABLE();
	I2C_InitTypeDef init;
	init.Timing = 0x0000DDDE;
	init.OwnAddress1 = 0;
	init.AddressingMode = I2C_ADDRESSINGMODE_7BIT;
	init.DualAddressMode = I2C_DUALADDRESS_DISABLE;
	init.OwnAddress2 = 0;
	init.OwnAddress2Masks = I2C_OA2_NOMASK;
	init.GeneralCallMode = I2C_GENERALCALL_DISABLE;
	init.NoStretchMode = I2C_NOSTRETCH_DISABLE;
	hi2c.Instance = I2C1;
	hi2c.Init = init;
	HAL_I2C_Init(&hi2c);
	InitializeI2CPins();
	HAL_I2CEx_ConfigAnalogFilter(&hi2c, I2C_ANALOGFILTER_ENABLE);
	HAL_I2CEx_ConfigDigitalFilter(&hi2c, 0);
}

HAL_StatusTypeDef I2CWrite(uint16_t addr, uint8_t* dat, uint8_t length)
{
	return HAL_I2C_Master_Transmit(&hi2c, addr, dat, length, I2CTimeout_ms);
}

HAL_StatusTypeDef I2CRead(uint16_t addr, uint8_t* dat, uint8_t length)
{
	return HAL_I2C_Master_Receive(&hi2c, addr, dat, length, I2CTimeout_ms);
}

HAL_StatusTypeDef I2CReadRegisters(uint16_t i2CAddress, uint8_t* writeDat, uint8_t writeLength, uint8_t* readDat, uint8_t readLength)
{
	HAL_StatusTypeDef err = HAL_I2C_Master_Transmit(&hi2c, i2CAddress, writeDat, writeLength, I2CTimeout_ms);
	if (err != HAL_OK)
	{
		return err;
	}
	
	err = HAL_I2C_Master_Receive(&hi2c, i2CAddress, readDat, readLength, I2CTimeout_ms);
	return err;
}

HAL_StatusTypeDef I2CReadMemory(uint8_t deviceAddr,uint8_t memoryAddr, uint8_t memorySizeBytes, uint8_t* buffer, uint8_t countToRead)
{
	HAL_StatusTypeDef err = HAL_I2C_Mem_Read(&hi2c,
		deviceAddr,
		memoryAddr,
		memorySizeBytes,
		buffer,
		countToRead,
		I2CTimeout_ms
	);
	return err;	
}
