rolfluc/ElectronicCribbage/(commit log)

2024-02-06 Schematic For Test Board 1, Layout Start
    [TB1.kicad_pcb, TB1.kicad_sch]
2024-02-06 Finished TB1 for Magnet Test
    [TB1.kicad_pcb]
2024-02-19 Adding Lighting Test Board - ordered
    [TB2.kicad_pcb, TB2.kicad_sch]
2024-02-19 Adding Bank Sensor for 6x10 design idea
    [Bank0.kicad_sch, Bank1.kicad_sch, SensorBoard.kicad_pcb, SensorBoard.kicad_sch]
2024-03-01 WIP - TBs ordered, Sensor board pre layout sensor board
    [Bank0.kicad_sch, Bank1.kicad_sch, MainBoard.kicad_pcb, MainBoard.kicad_sch, SensorBoard.kicad_pcb, SensorBoard.kicad_sch, Sensor_0_30.kicad_sch, Sensor_31_60.kicad_sch]
2024-03-01 First pass layout of LEDs/ Sensors
    [SensorBoard.kicad_pcb]
2024-03-01 More Layout
    [SensorBoard.kicad_pcb]
2024-03-01 All on top layer
    [SensorBoard.kicad_pcb, SensorBoard.kicad_sch]
2024-03-01 Front Layout, Smaller silkscreen
    [SensorBoard.kicad_pcb]
2024-03-01 Sensors attached to mainboard
    [MainBoard.kicad_pcb, MainBoard.kicad_sch, SensorBoard.kicad_pcb, SensorBoard.kicad_sch, Sensor_0_30.kicad_sch, Sensor_31_60.kicad_sch, sens0.kicad_sch, sens1.kicad_sch]
2024-03-02 New Layout - Better Sensorboard
    [MainBoard.kicad_pcb, SensorBoard.kicad_pcb]
2024-03-04 Mainboard Layout Setup
    [Bank0.kicad_sch, Bank1.kicad_sch, MainBoard.kicad_pcb, MainBoard.kicad_sch, SensorBoard.kicad_pcb, SensorBoard.kicad_sch, Sensor_0_30.kicad_sch, Sensor_31_60.kicad_sch]
2024-03-04 First pass exterior
    [MainBoard.kicad_pcb]
2024-03-23 WIP - Moving Sensor to IO Expander
    [Bank0.kicad_sch, Bank1.kicad_sch, Display.kicad_sch, MainBoard.kicad_pcb, MainBoard.kicad_sch, Power.kicad_sch, SensorBoard.kicad_pcb, SensorBoard.kicad_sch]
2024-03-23 Fix of Multiplexing
    [Bank0.kicad_sch, Bank1.kicad_sch, SensorBoard.kicad_pcb, SensorBoard.kicad_sch]
2024-03-23 Fixing Routing
    [SensorBoard.kicad_pcb]
2024-03-23 Fixed Routing
    [SensorBoard.kicad_pcb, SensorBoard.kicad_sch]
2024-03-23 Fixed Silkscreens
    [SensorBoard.kicad_pcb]
2024-03-24 Updated layout, and placement for main board
    [Display.kicad_sch, MainBoard.kicad_pcb, MainBoard.kicad_sch, Power.kicad_sch, SensorBoard.kicad_pcb, mcu.kicad_sch, sens0.kicad_sch, sens1.kicad_sch]
2024-03-24 Routed PCB, Need SCL/SDA still
    [MainBoard.kicad_pcb, MainBoard.kicad_sch, Power.kicad_sch, mcu.kicad_sch]
2024-03-24 First pass Finalized Layout. Pending Sensing board changes.
    [MainBoard.kicad_pcb, MainBoard.kicad_sch]
2024-03-25 Pre Order for Sensor Board
    [MainBoard.kicad_pcb]
2024-05-11 WIP - Working on Peg Logic
    [Power.kicad_sch, SensorBoard.kicad_sch, mcu.kicad_sch]
2024-05-12 Display Theoretically working
    Display changed to show left or right on timer change.
2024-05-12 WIP - Pin and Point Handling
2024-05-23 Replacement after sensing change
    [Bank0.kicad_sch, Bank1.kicad_sch, SensorBoard.kicad_pcb, SensorBoard.kicad_sch]
2024-05-23 Potential Layout - Inverted 1 chip for layout
    [SensorBoard.kicad_pcb, SensorBoard.kicad_sch]
2024-05-24 Shipped new boards
    [Bank0.kicad_sch, Bank1.kicad_sch, SensorBoard.kicad_pcb, SensorBoard.kicad_sch]
2024-10-02 Routine Update
    [Bank0.kicad_sch, Bank1.kicad_sch, Display.kicad_sch, MainBoard.kicad_pcb, MainBoard.kicad_sch, Power.kicad_sch, SensorBoard.kicad_pcb, SensorBoard.kicad_sch]
2024-10-20 Random Check in
    [Bank0.kicad_sch, Bank1.kicad_sch, Display.kicad_sch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]
2024-10-21 Sample Board for Power Supplies, Micro, And LED Driving.
    [PowerDriveTest.kicad_pcb, PowerDriveTest.kicad_sch]
2024-10-24 First pass layout
    Assumes using Cut-through RGB 7 Segment
    [Display.kicad_sch, MainBoard.kicad_pcb, MainBoard.kicad_sch, PinSense.kicad_sch, Power.kicad_sch, mcu.kicad_sch]
2024-10-24 Adding Ground Stitches
    [MainBoard.kicad_pcb]
2024-11-17 New Power Board off to mfging
    [PowerDriveTest.kicad_pcb, PowerDriveTest.kicad_sch]
2024-11-17 MCU Modification
    Migrated to g431, as is used elsewhere.
    [Power.kicad_sch, mcu.kicad_sch]
2024-12-24 Routine Checkout
    [Power.kicad_sch, PowerDriveTest.kicad_pcb, PowerDriveTest.kicad_sch]
2025-01-02 Potential Layout. Need to confirm button and L&F.
    [Display.kicad_sch, MainBoard.kicad_pcb, MainBoard.kicad_sch, PinSense.kicad_sch, Power.kicad_sch, mcu.kicad_sch]
2025-02-03 Potential Revision
    Potentially fabb-able rev.
    [Display.kicad_sch, MainBoard.kicad_pcb, MainBoard.kicad_sch, PinSense.kicad_sch, Power.kicad_sch, mcu.kicad_sch]
2025-03-13 Checkin of Fabbed Board
    [MainBoard.kicad_pcb, PinSense.kicad_sch, mcu.kicad_sch]
2025-04-06 PinDef Assigned, Power Handler Started, to ensure power remains on after boot
2025-04-06 Removing PWM References
2025-04-06 Started HB, Migrated SPI control of LEDs
2025-04-06 Display Control Scheme Change, ADC Added but incomplete
2025-04-28 Positioning for Boards
    [CribbageCase.FCStd]
2025-04-28 WIP case. Added supports for pegs.
    [CribbageCase.FCStd]
2025-04-28 Base Exterior Case
    [CribbageCase.FCStd]
2025-04-30 WIP case top
    [CribbageCase.FCStd]
2025-07-29 Printed Case
    [CribbageCase.FCStd]
2025-07-29 Updated EE
    [MainBoard.step, Power.kicad_sch]
2025-08-02 Untested Display State Machine
    In theory, Display should be close to working for scrolling text.
    Has a User vs System display, as User can request battery voltage.
2025-08-03 Working Display State Machine, Not Working Peg Reader
    [Display.c, I2C.c, I2C.h, PegHandler.c, Segment.c, TCA9555.c]
2025-08-09 Working On Board Pegs
2025-08-18 Updating Format, Adding Rev2 Start
    [Display.kicad_sch, MCU.kicad_sch, MainBoard.kicad_sch, Motherboard.kicad_pcb, Motherboard.kicad_sch, PinSense.kicad_sch, Power.kicad_sch, Sensing.kicad_sch]
2025-08-18 Schematic Change, Attempting new power circuit to turn off, with MCU
    [PowerDriveTest.kicad_sch]
2025-08-19 Placement Update
    [PowerDriveTest.kicad_pcb]
2025-08-20 Better working Timing / Switching for early state machine
2025-08-23 Delta appears to be working correctly.
    [PegHandler.c]
2025-08-23 Enabling Button Hold to Reset Game
    [PegHandler.c, PowerHandler.c]
2025-08-23 Fixed Blinking Issue with incorrect Timing, Peg Handling
    [PegHandler.c, SPI.c]
2025-08-24 Adding Pegs to version control
    [CribbagePeg.FCStd]
2025-08-24 Adding holes to contain the pegs
    Still need mounting brackets.
    [CribbageCase.FCStd]
2025-08-25 Printed Model
    [CribbageCase.FCStd]
2025-08-26 Added Insert for Peg holes for storage
    [CribbageCase.FCStd]
2025-08-26 Functioning ADC
2025-08-27 Working Voltage Reading
2025-08-29 Adding Test Circuit 2
    [PowerDriveTest.kicad_pcb, PowerDriveTest.kicad_sch]
